CircuitCo/BeagleBone-3.1MP-Camera-RevA1/BeagleBone-3.1MP-Camera-Sensor-RevA1-bom.xls

BeagleBone 3.1MP CAMERA SENSOR COVER PAGE Revised: Thursday, July 05, 2012
BBT-BONE-CAM3-01 Revision: A1
Item | Quantity | Reference | Part | PCB Footprint | DESCRIPTION | MAN | PART #
1 | 3 | C1,C3,C5 | 10uF,10V | 805 | CAP CER 10UF 10V Y5V 0805 | TDK | C2012Y5V1A106Z
2 | 9 | C2,C4,C6,C7,C8,C9,C10,C11,C37 | 0.1uF | 402 | Capacitor 0.1uF 16V 10% 0402 X7R | Kemet | C0402C104K4RACT
3 | 1 | FB1 | MMZ1608R301A | IND603-24X32 | FERRITE CHIP 300 OHM 500MA 0603 | TDK | MMZ1608R301A
4 | 1 | J1 | AXT524124 | HDR2X12SMD_P4MM_7P4X3P0 | CONN SOCKET F4S .4MM 24POS SMD | Panasonic Electric Works | AXT524124
5 | 1 | J2 | CON3 | SIP3
6 | 2 | J3,J4 | HEADER 15X2 | HDR2X15SMD_RA | CONN HEADER 30POS DUAL .05" SMD | Samtec | FTSH-115-04-L-DH
7 | 2 | R1,R2 | 0 | 402 | Resistor Zero ohm Jumper 0402 | Yageo | RC0402JR-070RL
8 | 6 | R3,R7,R8,R9,R10,R54 | 10K | 402 | Resistor 10Kohm 1/16W 5% 0402 | Rohm | MCR01MZPJ103
9 | 1 | R4 | 33 | 402 | RES 33.0 OHM 1/16W 1% 0402 SMD | Yaego | RC0402FR-0733RL
10 | 0 | R5 | 0, DNI | 402
11 | 2 | R49,R50 | 5.6K,5% | 402 | RES 5.6K OHM 1/16W 5% 0402 SMD | Yaego | RC0402JR-075K6L
12 | 3 | R51,R52,R53 | 4.75K | 402 | RES 4.75K OHM 1/16W 1% 0402 SMD | Stackpole Electronics | RMCF0402FT4K75
13 | 1 | TH1 | CAM_THERMAL | therm | Sensor: Micron/Aptina 1/4“ CMOS Sensor MT9T111 (SoC3130) | Leopard Imaging | LI-3M02CM
14 | 0 | TP1,TP2 | T POINT A | tp
15 | 1 | U1 | SN74AVC1T45 | SC70-6 | IC BUS TRANSCVR TRI-ST SC706 | TI | SN74AVC1T45DCKR
16 | 1 | U2 | TXS0102DCU | DCU8-10X50 | IC VOLT-LEVEL TRANSLATOR 8-US8 | TI | TXS0102DCUR
17 | 1 | U3 | SN74LVC1G07DCK | DCK5 | IC BUFF/DVR NON-INVERT SC705 | TI | SN74LVC1G07DCKR
18 | 1 | U5 | CAT24C256W | SOIC_8 | IC EEPROM 256KBIT 400KHZ 8SOIC | ON | CAT24C256WI-G
