CircuitCo/BeagleBone-3.1MP-Camera-RevA1/BeagleBone-Camera-Expansion-RevA1-bom.xls

BeagleBone CAMERA Expansion Cape COVER PAGE Revised: Thursday, July 05, 2012
BBT-BONE-CAME-01 Revision: A1
Item | Quantity | Reference | Part | PCB Footprint | DESCRIPTION | MAN | PART #
1 | 6 | C1,C2,C3,C6,C38,C39 | 10uF,10V | 805 | CAP CER 10UF 10V Y5V 0805 | TDK | C2012Y5V1A106Z
2 | 22 | C4,C5,C7,C8,C9,C10,C11,C12,C13,C14,C15,C16,C17,C18,C19,C20,C21,C22,C23,C24,C25,C26 | 0.1uF | 402 | Capacitor 0.1uF 16V 10% 0402 X7R | Kemet | C0402C104K4RACT
3 | 2 | D1,D2 | LTST-C190GKT | led2-31sq | LED GREEN CLEAR 0603 SMD | Lite-On Inc | LTST-C190GKT
4 | 2 | P1,P2 | FEMALE HEADER 2x23 | HEADER23X2 | .100 CL Dual Row- Straight Socket Strip- using .025" Sq. Pins | MLE | SSHQ-123-D-08-F-LF
5 | 1 | P3 | HDR5x2 | HEADER10X2 | .100 CL Dual Row- Straight Socket Strip- using .025" Sq. Pins | MLE | SSHQ-105-D-08-F-LF
6 | 2 | P4,P5 | HEADER 15X2 | CON30SMD_245X865 |  | Samtec | SFMH-115-02-L-D-WT
7 | 1 | Q1 | DMC56404 | SMini6-F3-B | TRANS PREBIASED DUAL NPN | Diodes, Inc | DDC114YU-7-F
8 | 0 | R1,R6 | 0,DNI | 603
9 | 2 | R2,R7 | 0 | 603 | RES 0.0 OHM 1/10W 0603 SMD | Yageo | RC0603JR-070RL
10 | 1 | R3,R59 | 10K | 402 | Resistor 10Kohm 1/16W 5% 0402 | Rohm | MCR01MZPJ103
11 | 1 | R4 | 28K | 402 | RES 28K OHM 1/16W 1% 0402 SMD |  | RC0402FR-0728KL
12 | 1 | R5 | 56.2K | 402 | RES 56.2K OHM 1/16W 1% 0402 SMD |  | ERJ-2RKF5622X
13 | 1 | R8 | 44.2k | 402 | RES 44.2K OHM 1/16W 1% 0402 SMD |  | RMCF0402FT44K2
14 | 1 | R9 | 33.2k | 402 | RES 33.2K OHM 1/16W 1% 0402 SMD |  | RMCF0402FT33K2
15 | 19 | R10,R12,R13,R16,R19,R23,R28,R29,R30,R31,R32,R33,R34,R35,R36,R37,R38,R39,R40 | 33 | 402 | RES 33.0 OHM 1/16W 1% 0402 SMD | Yaego | RC0402FR-0733RL
16 | 0 | R11,R22,R41,R42,R43 | 10K,DNI | 402
17 | 1 | R44 | 0 | 402 | RES 0.0 OHM 1/10W 0402 SMD | Yageo | RC0402JR-070RL
18 | 0 | R45 | 0, DNI | 402
19 | 2 | R55,R56 | 470 | 402 | RES 470 OHM 1/16W 1% 0402 SMD | Yageo | RC0402FR-07470RL
20 | 2 | R121,R122 | 100K,1% | 402 | RES 100K OHM 1/16W 1% 0402 SMD | Yageo | RC0402FR-07100KL
21 | 1 | SW1 | SW DIP-2 | swdip4_100-339smd | SWITCH TAPE SEAL 2 POS SMD | CTS | 219-2MST
22 | 2 | U1,U2 | TPS73701DRBR | drb8-14x33-pad | IC REG LDO CAP FREE 8-SON | TI | TPS73701DRBR
23 | 1 | U3 | SN74LVC1G07DCK | DCK5 | IC BUFF/DVR NON-INVERT SC705 | TI | SN74LVC1G07DCKR
24 | 1 | U4 | CSSP_6mmX6mm | BGA86_6X6_P5MM |  | QuickLogic | CSSP-FPUN86-6494
