CircuitCo/BeagleBone-3.1MP-Camera-RevA1/BeagleBone-3.1MP-Camera-Sensor-RevA1-schematic.pdf

## 04/04/2012 BBT

# DATE

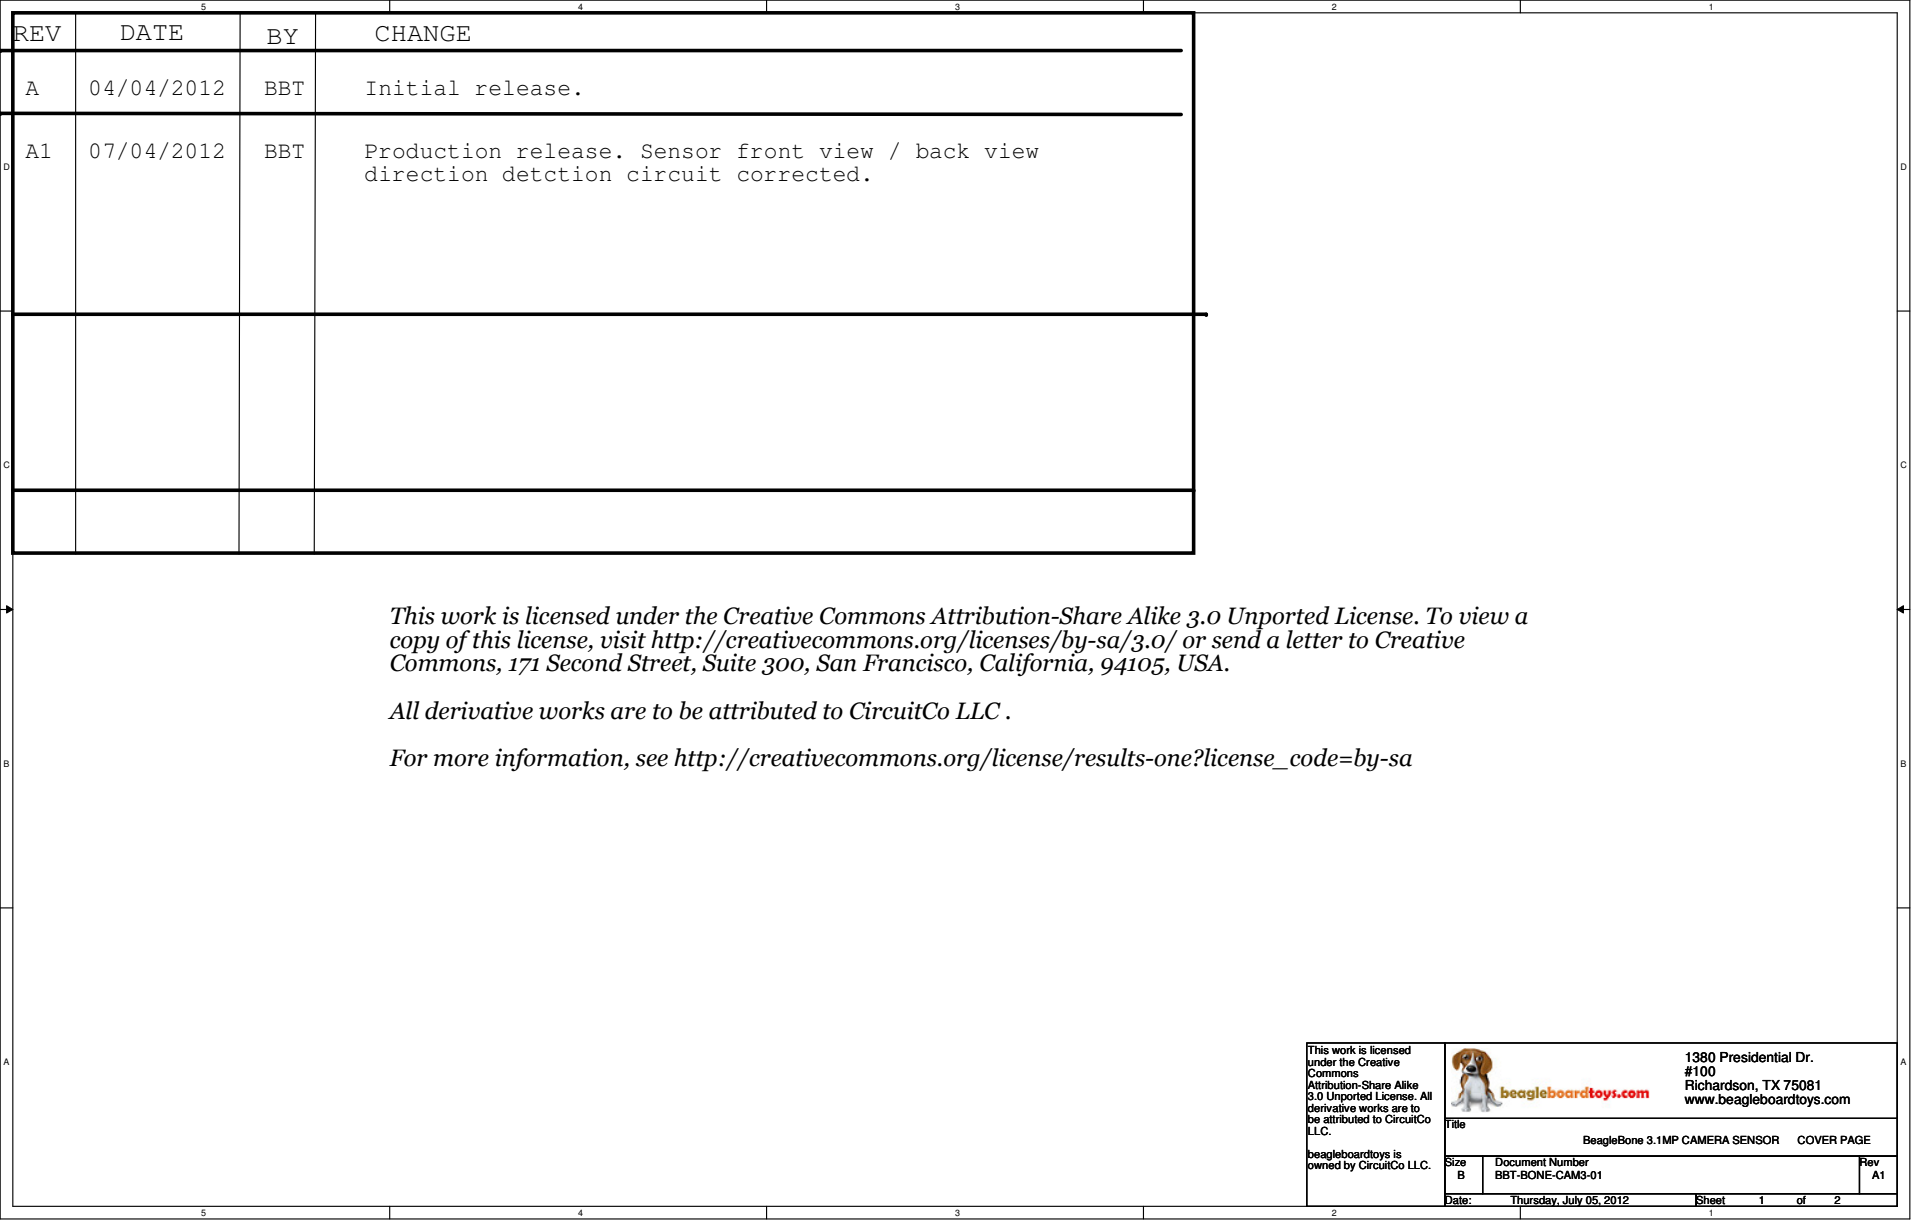
[picture p1: page 1]
REV; CHANGE; Initial release.; Production release. Sensor front view / BBT; back view; Title; Size; Document Number; Rev; Date:; Sheet; BBT-BONE-CAM3-01; BeagleBone 3.1MP CAMERA SENSOR; COVER PAGE; Thursday, July 05, 2012

direction detction circuit corrected.

This work is licensed under the Creative Commons Attribution-Share Alike 3.0 Unported License. To view a
copy of this license, visit http://creativecommons.org/licenses/by-sa/3.0/ or send a letter to Creative
Commons, 171 Second Street, Suite 300, San Francisco, California, 94105, USA.

All derivative works are to be attributed to CircuitCo LLC .

For more information, see http://creativecommons.org/license/results-one?license_code=by-sa

This work is licensed
under the Creative
Commons
Attribution-Share Alike
3.0 Unported License. All
derivative works are to
be attributed to CircuitCo
LLC.

1380 Presidential Dr.
Richardson, TX 75081
www.beagleboardtoys.com

beagleboardtoys is
owned by CircuitCo LLC.

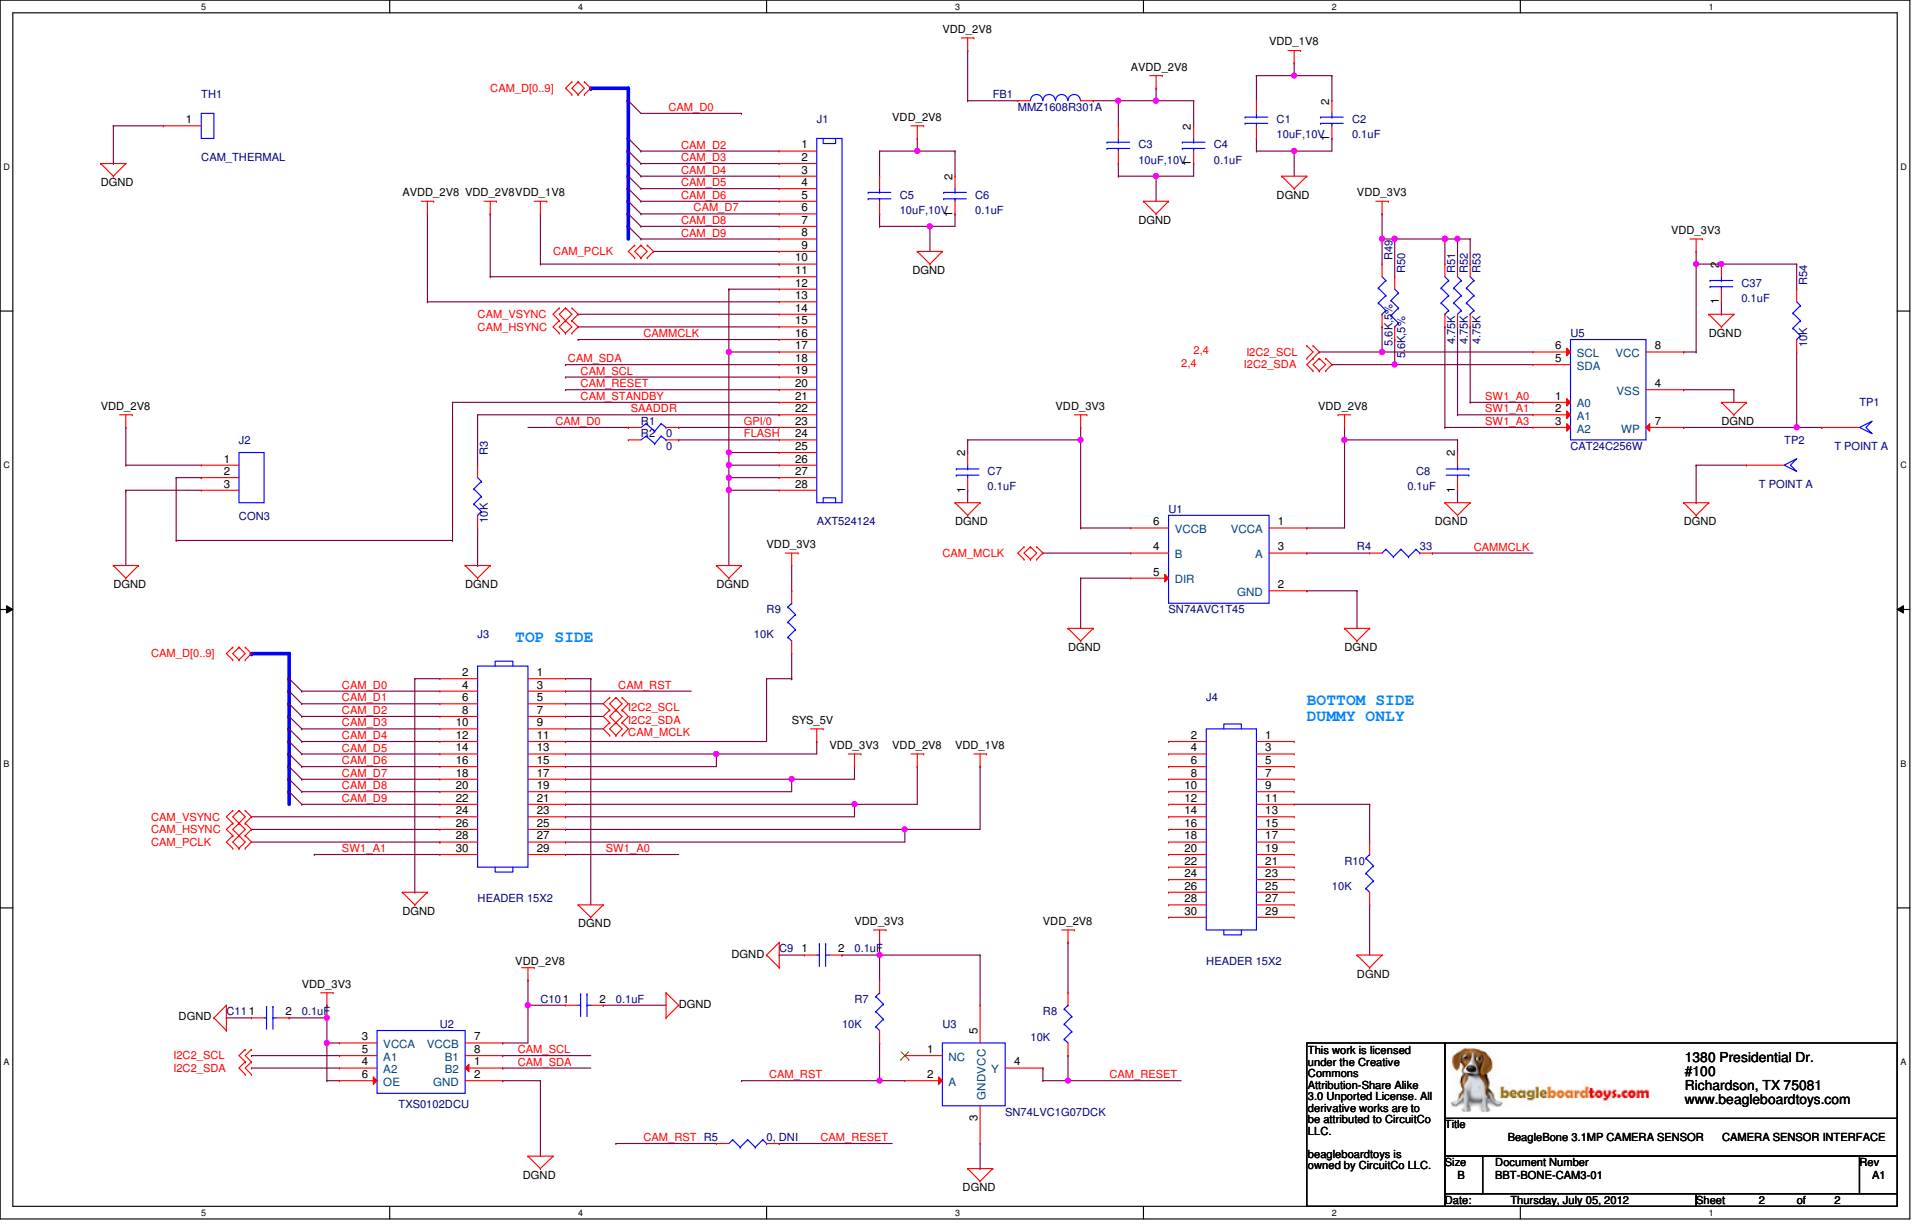
[picture p2: page 2]
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

beagleboardtoys is
owned by CircuitCo LLC.
