CircuitCo/BeagleBone-3.1MP-Camera-RevA1/BeagleBone-Camera-Expansion-RevA1-schematic.pdf

# 03/12/2012 BBT

# DATE

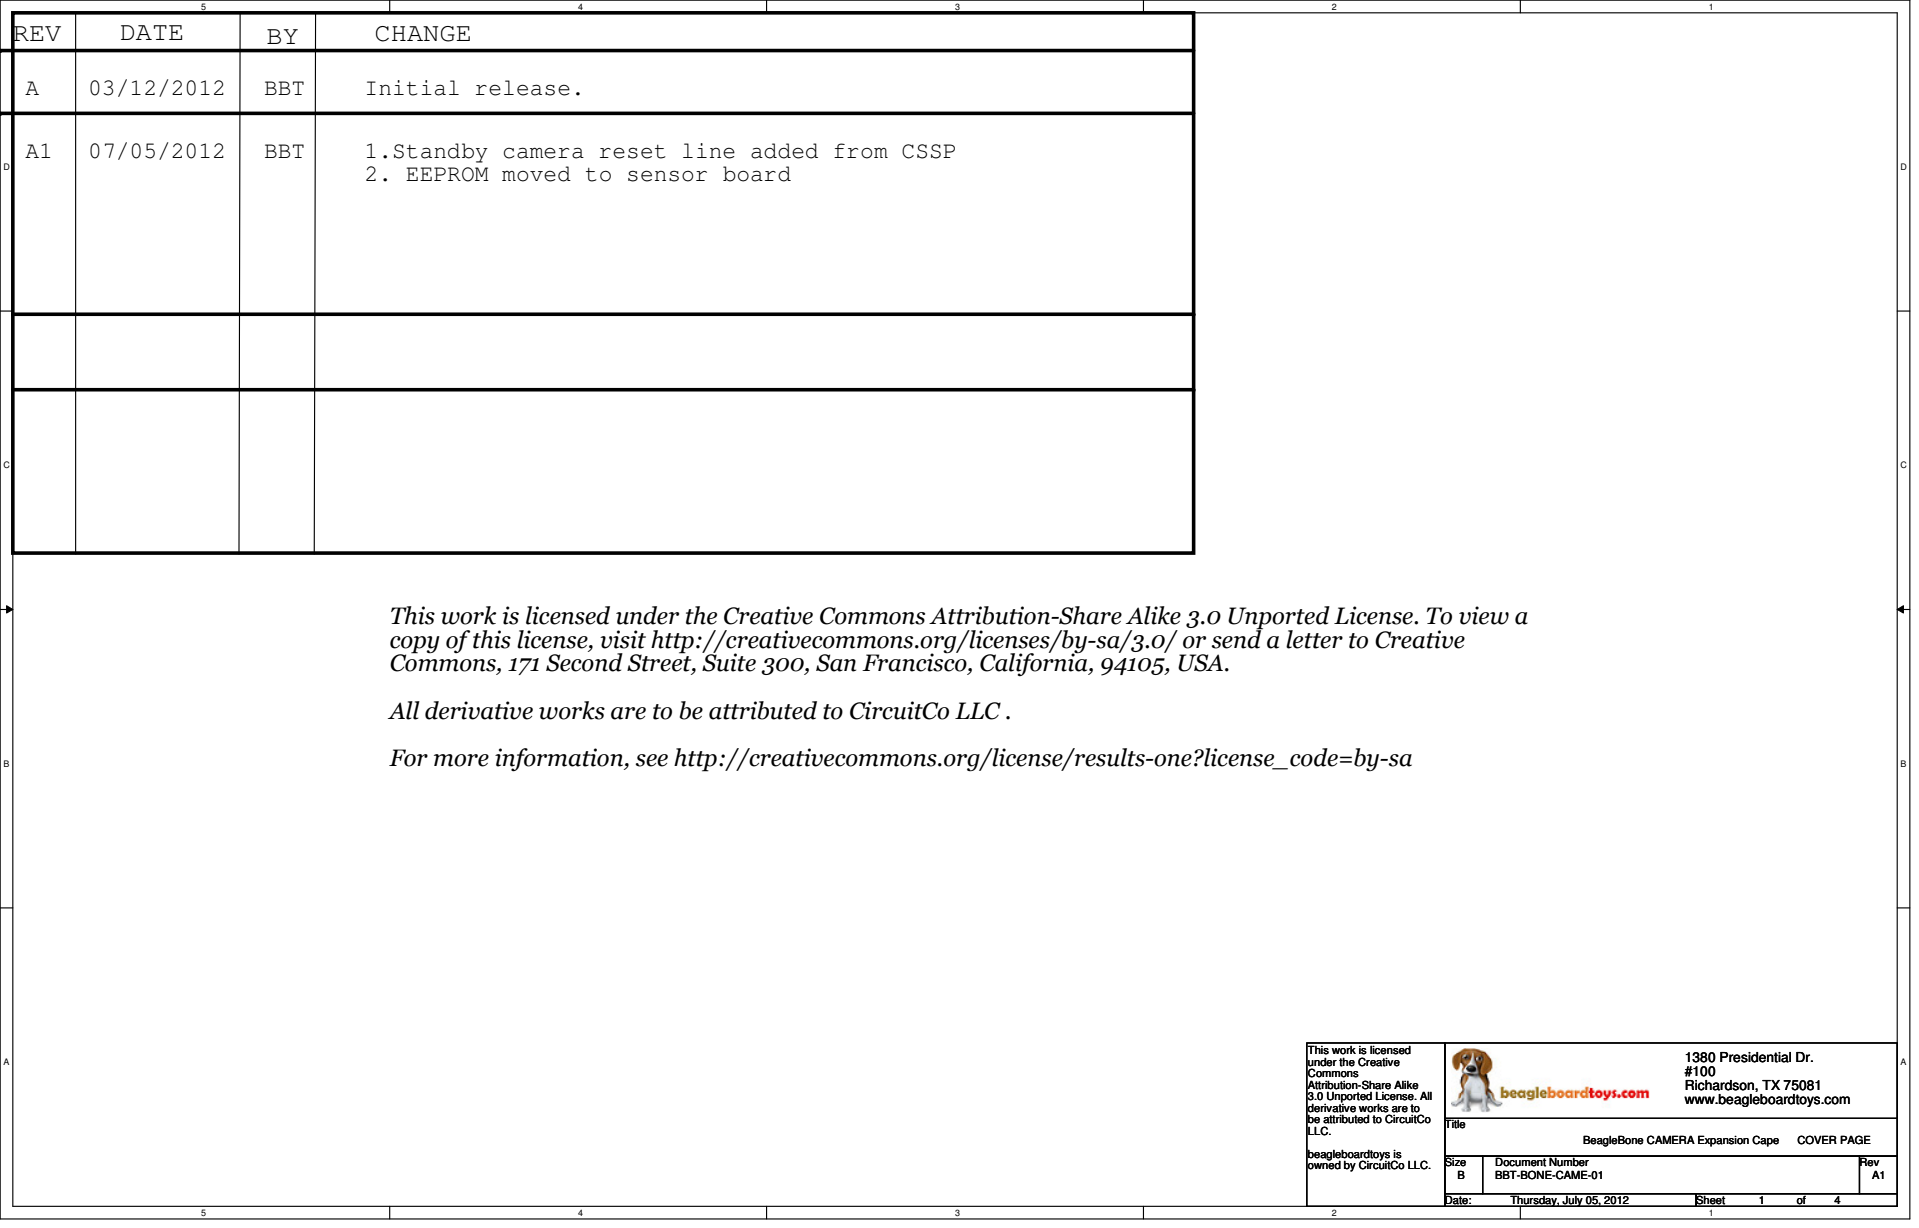
[picture p3: page 1]
REV; CHANGE; Initial release.; 1.Standby camera reset line added from BBT; CSSP; Title; Size; Document Number; Rev; Date:; Sheet; BBT-BONE-CAME-01; BeagleBone CAMERA Expansion Cape; COVER PAGE; Thursday, July 05, 2012

2. EEPROM moved to sensor board

This work is licensed under the Creative Commons Attribution-Share Alike 3.0 Unported License. To view a
copy of this license, visit http://creativecommons.org/licenses/by-sa/3.0/ or send a letter to Creative
Commons, 171 Second Street, Suite 300, San Francisco, California, 94105, USA.

All derivative works are to be attributed to CircuitCo LLC .

For more information, see http://creativecommons.org/license/results-one?license_code=by-sa

This work is licensed
under the Creative
Commons
Attribution-Share Alike
3.0 Unported License. All
derivative works are to
be attributed to CircuitCo
LLC.

1380 Presidential Dr.
Richardson, TX 75081
www.beagleboardtoys.com

beagleboardtoys is
owned by CircuitCo LLC.

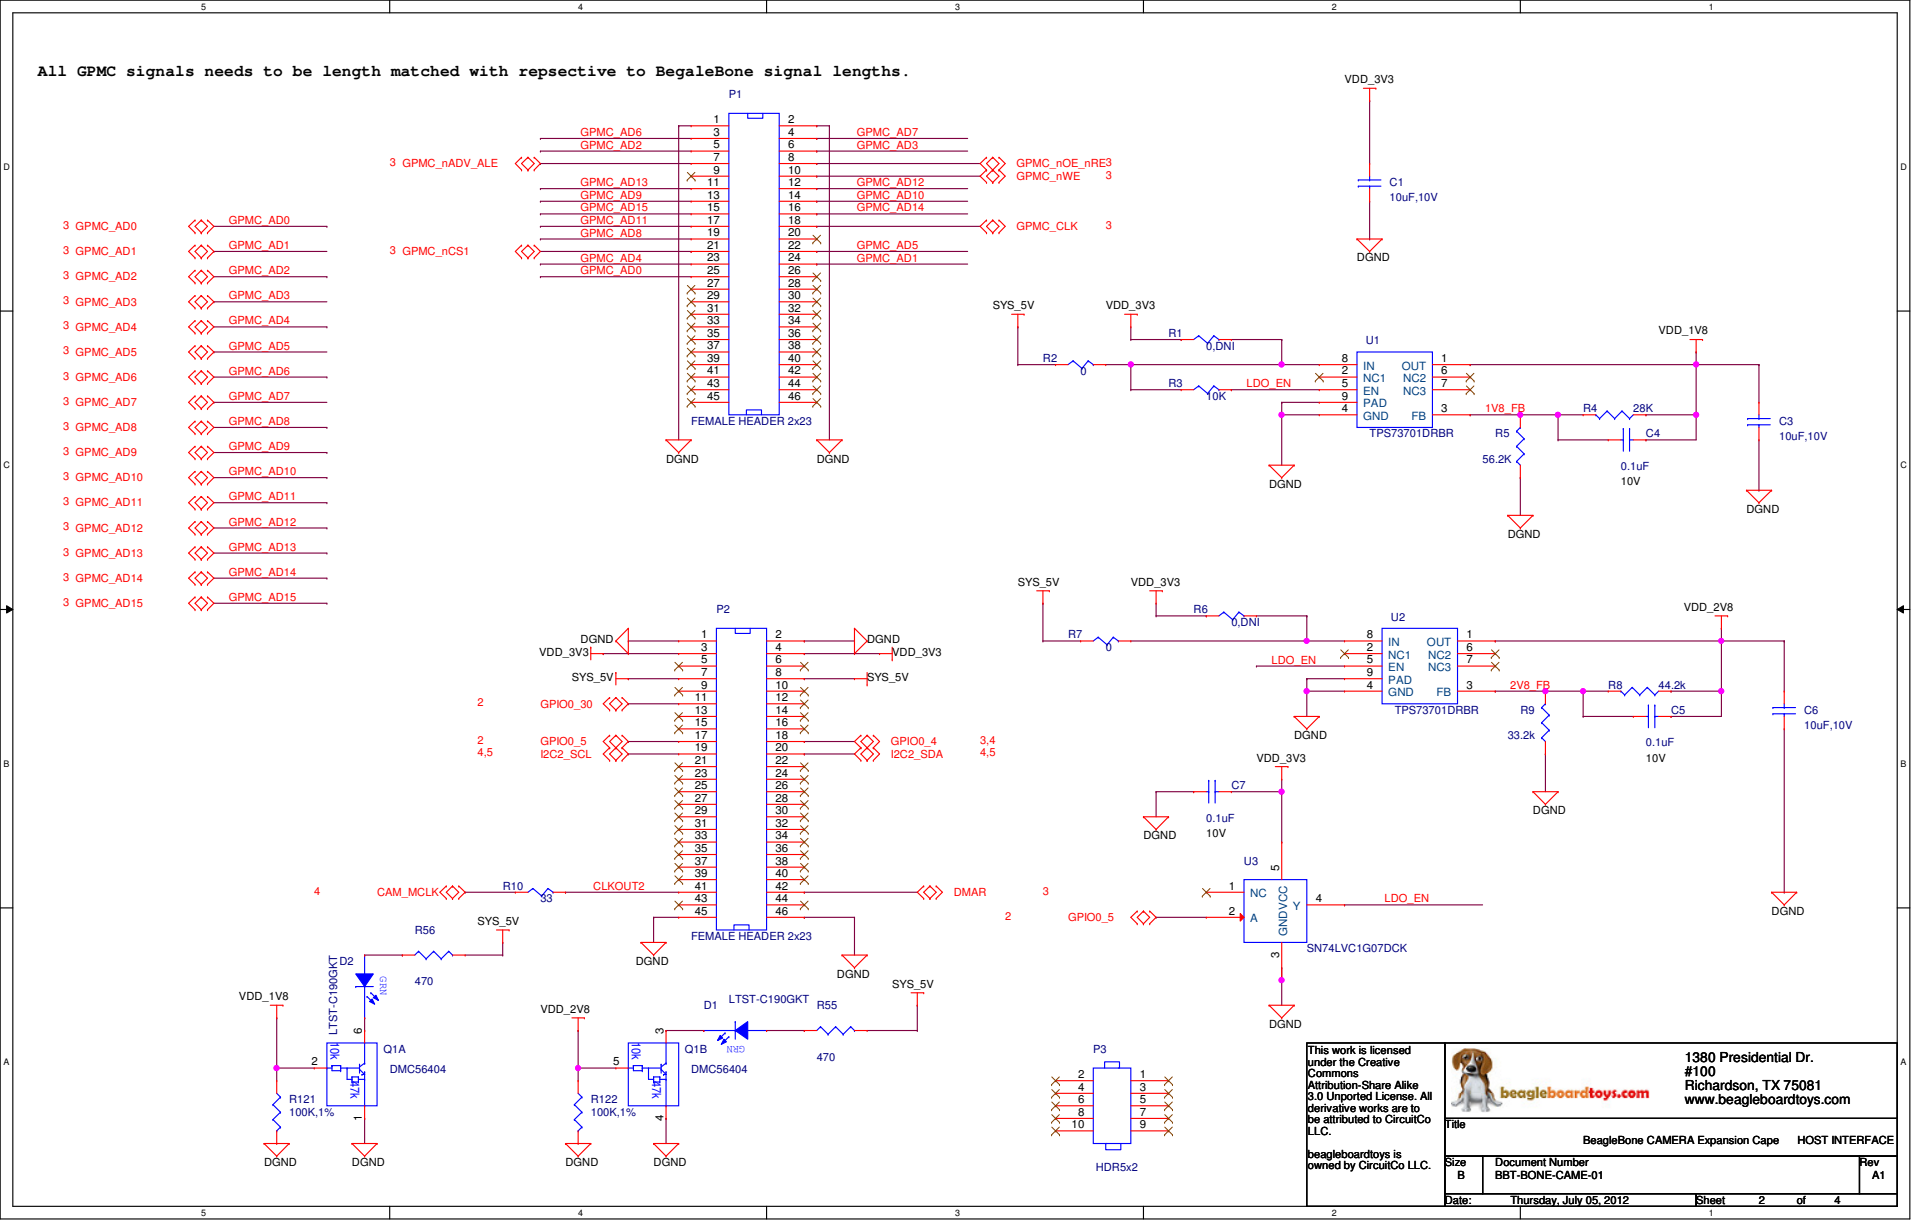
[picture p4: page 2]

All GPMC signals needs to be length matched with repsective to BegaleBone signal lengths.

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

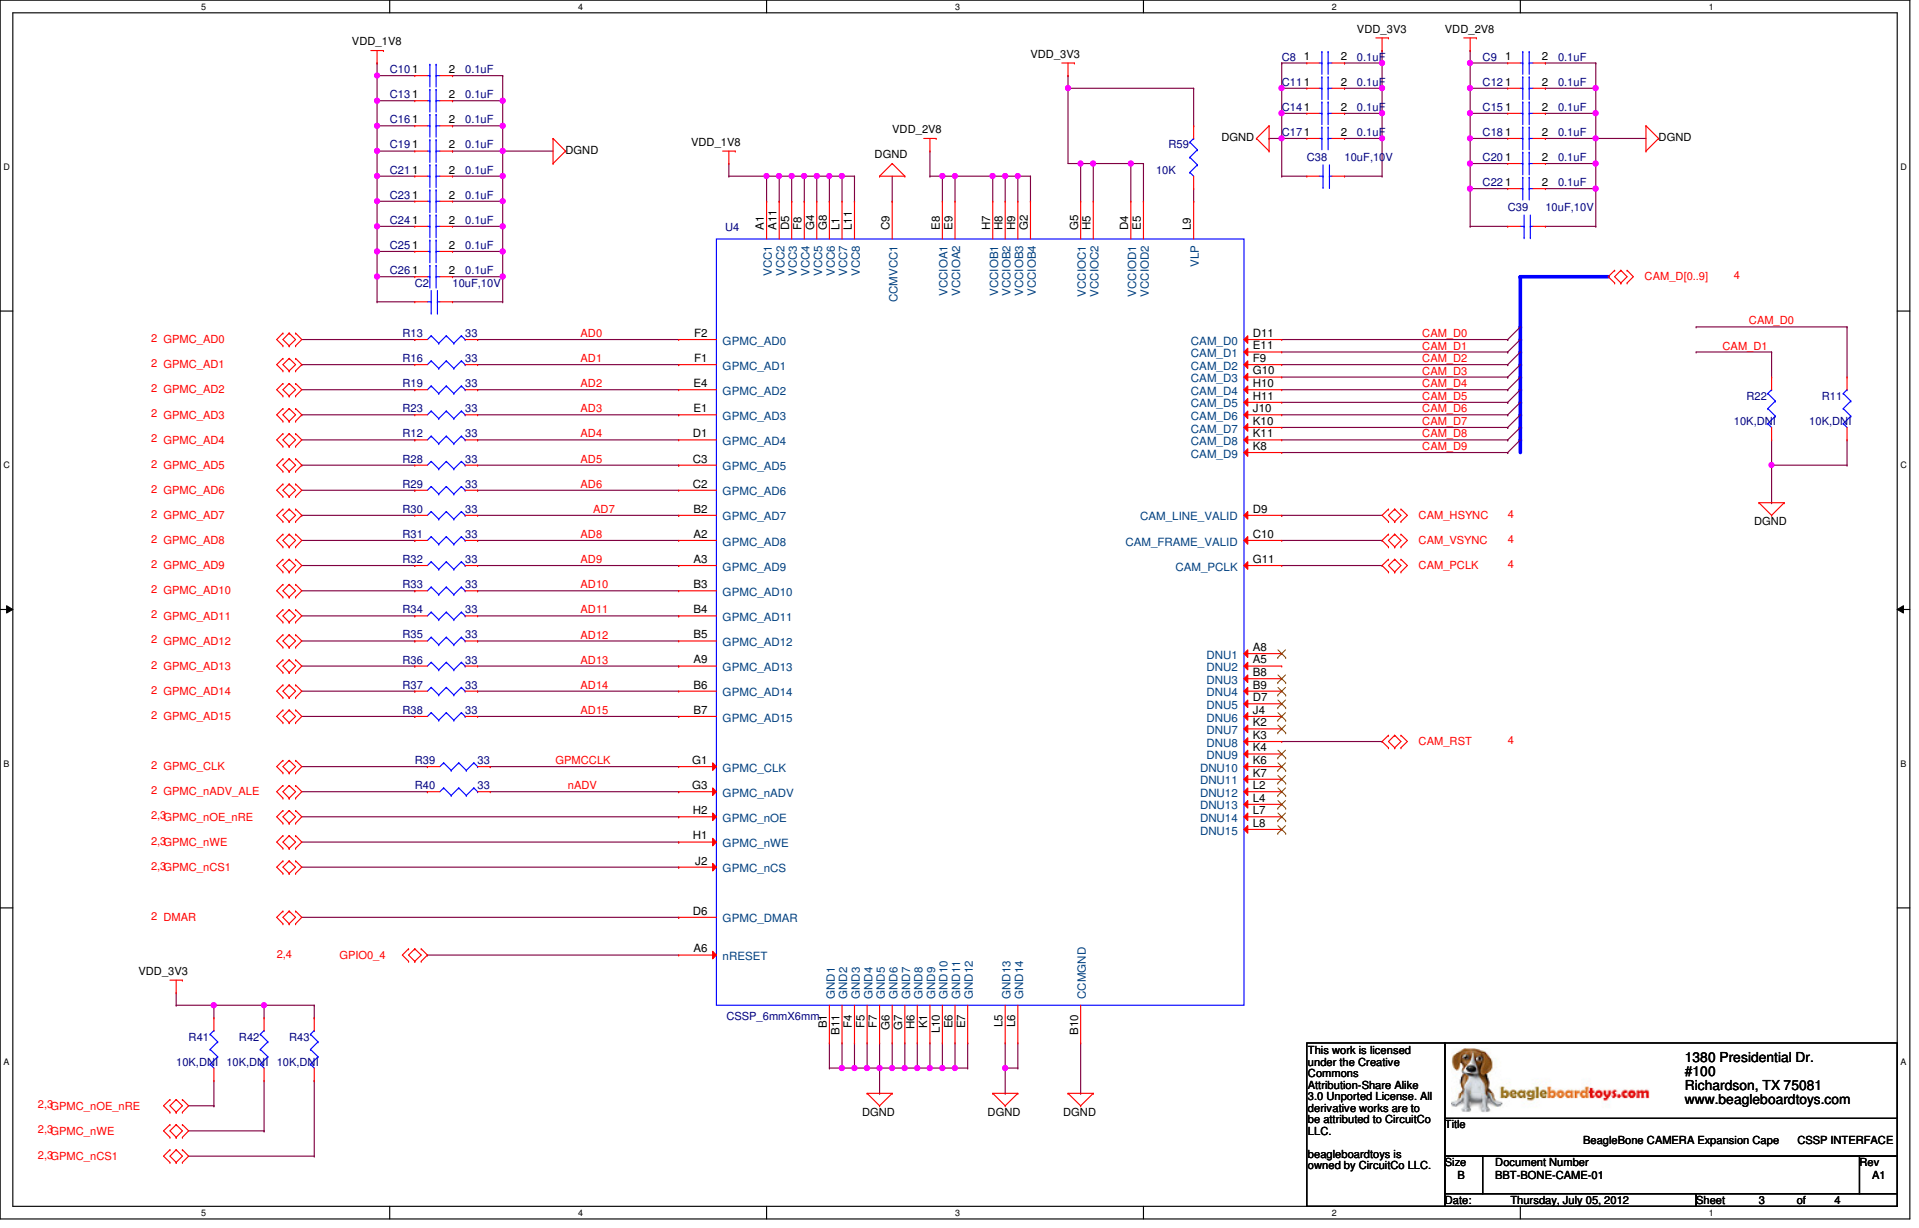
[picture p5: page 3]
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

## TOP SIDE

## BACK VIEW

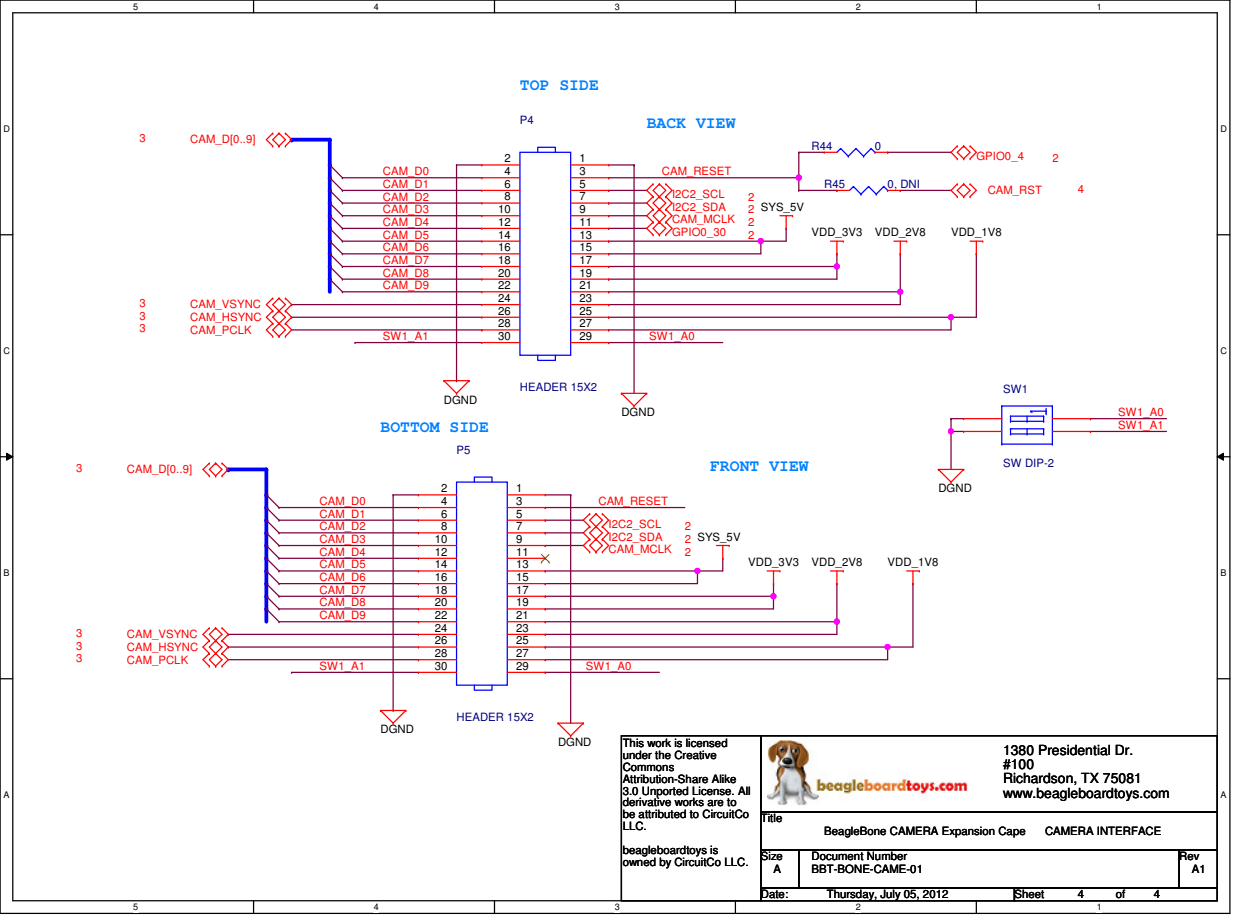
[picture p6: page 4]
BOTTOM SIDE; FRONT VIEW; CAM_D2 CAM_D3 CAM_D4 CAM_D5 CAM_D6 CAM_D7 CAM_D8 CAM_D9; CAM_D0 CAM_D1; CAM_RESET; DGND; VDD_3V3 VDD_2V8; VDD_1V8; SYS_5V; 3 CAM_D[0..9]; 3 CAM_VSYNC 3 CAM_HSYNC 3 CAM_PCLK; CAM_MCLK; GPIO0_4; I2C2_SCL; I2C2_SDA; GPIO0_30; CAM_RST; Title; BeagleBone CAMERA Expansion Cape; CAMERA INTERFACE; Thursday, July 05, 2012; HEADER 15X2; SW DIP-2; 0, DNI

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

1380 Presidential Dr.
Richardson, TX 75081
www.beagleboardtoys.com
