CircuitCo/BeagleBone-3.1MP-Camera-RevA1/(list of files, drawings)

Other design files:
BeagleBone-3.1MP-Camera-Sensor-RevA1-schematic.dsn
BeagleBone-Camera-Expansion-RevA1-schematic.dsn
